renouxfabrice/action-camera-orthophoto-validation/hardware/rolling_shutter_bench/README.md

# The LED bench

Bill of materials, wiring and the blink rates used.
