renouxfabrice/action-camera-orthophoto-validation/src/photogrammetry/README.md

# Processing

ODM project preparation, camera model import, orthophoto quality control.
