renouxfabrice/action-camera-orthophoto-validation/data/derived/rolling_shutter/README.md

# Measured readout times

One row per camera and capture mode, with uncertainty and number of repeats.
