renouxfabrice/action-camera-orthophoto-validation/data/raw/drone_flight/README.md

# Instrumented flight

Images, mission logs, GNSS rover and base logs, ground control, weather, flight plan.
