renouxfabrice/action-camera-orthophoto-validation/data/raw/rolling_shutter/README.md

# Raw bench photographs

One folder per camera model and capture mode, with the manifest recording blink rate, exposure, ISO and distance.
