renouxfabrice/action-camera-orthophoto-validation/data/echantillon/hero4_champ_large_7mpx/GOPR3876.JPG

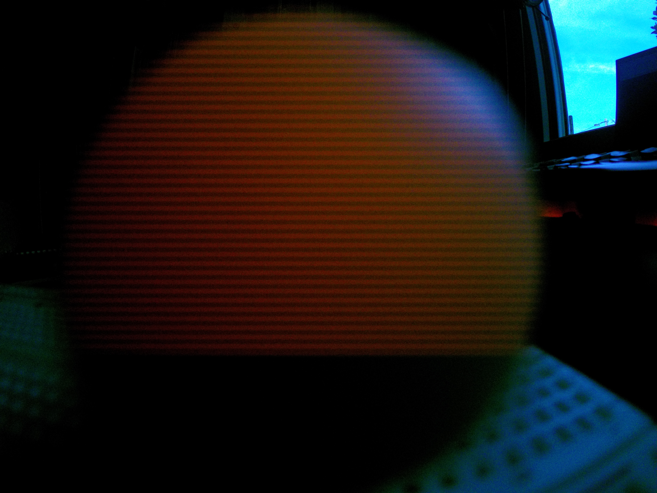
data/echantillon/hero4_champ_large_7mpx/GOPR3876.JPG
