renouxfabrice/action-camera-orthophoto-validation/data/echantillon/hero4_champ_large_12mpx/GOPR2091.JPG

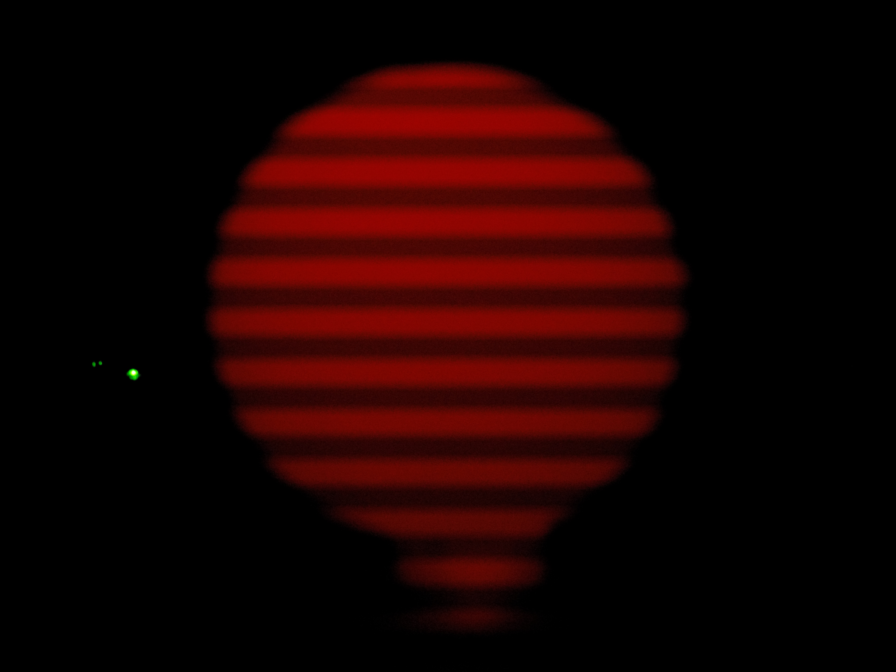
data/echantillon/hero4_champ_large_12mpx/GOPR2091.JPG
