renouxfabrice/action-camera-orthophoto-validation/data/echantillon/hero4_champ_moyen_7mpx/GOPR2212.JPG

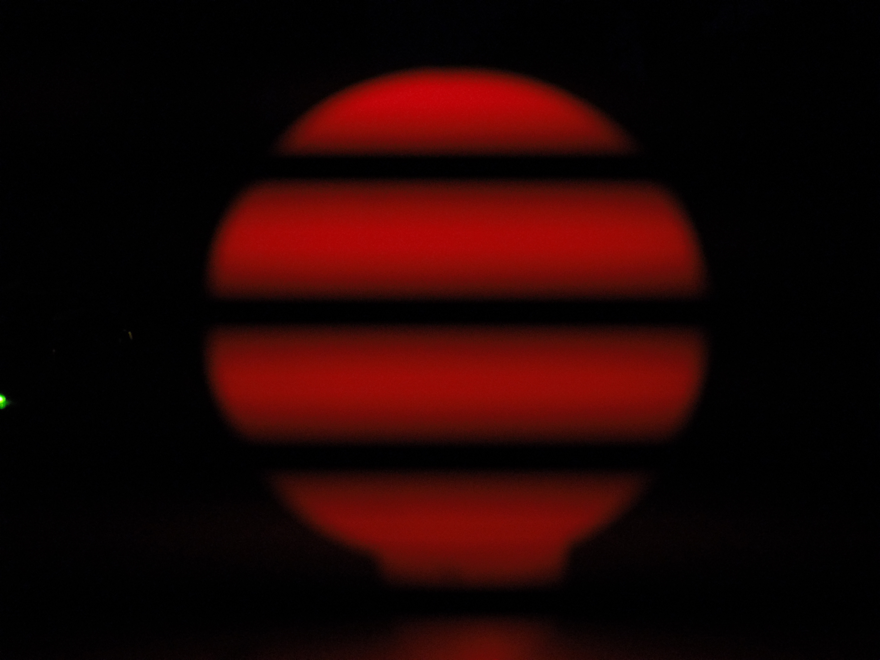
data/echantillon/hero4_champ_moyen_7mpx/GOPR2212.JPG
