renouxfabrice/action-camera-orthophoto-validation/data/echantillon/hero4_champ_moyen_7mpx/GOPR2308.JPG

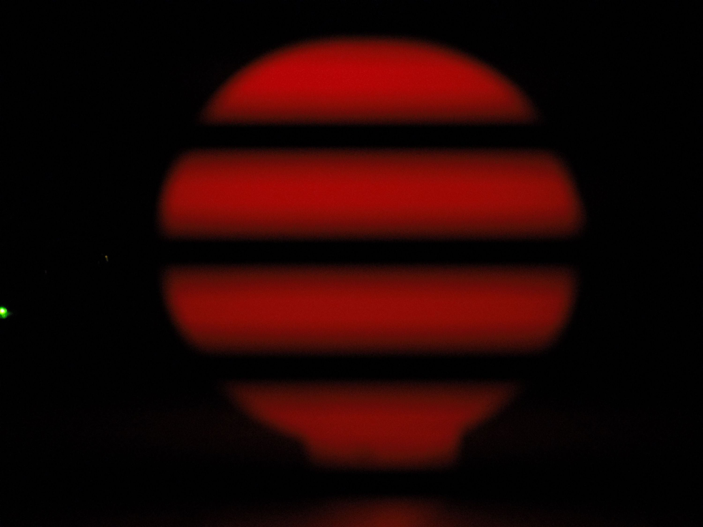
data/echantillon/hero4_champ_moyen_7mpx/GOPR2308.JPG
