renouxfabrice/action-camera-orthophoto-validation/data/echantillon/hero13_lineaire_iso800/GP010539.JPG

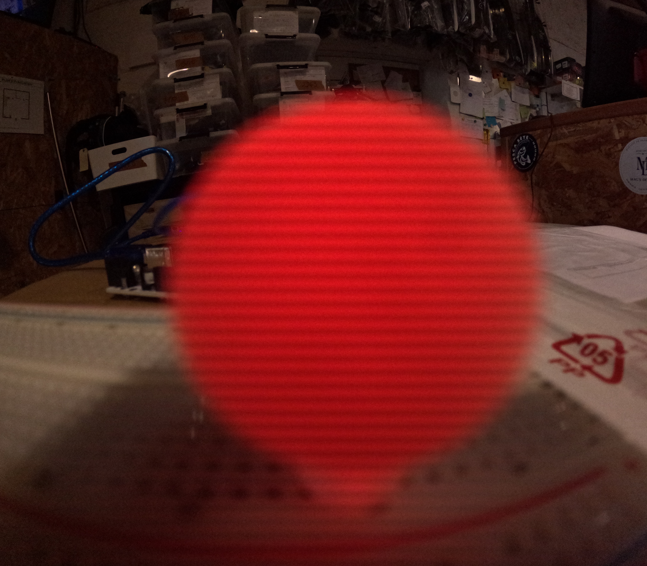
data/echantillon/hero13_lineaire_iso800/GP010539.JPG
