renouxfabrice/action-camera-orthophoto-validation/data/echantillon/hero13_lineaire_iso800/GP010551.JPG

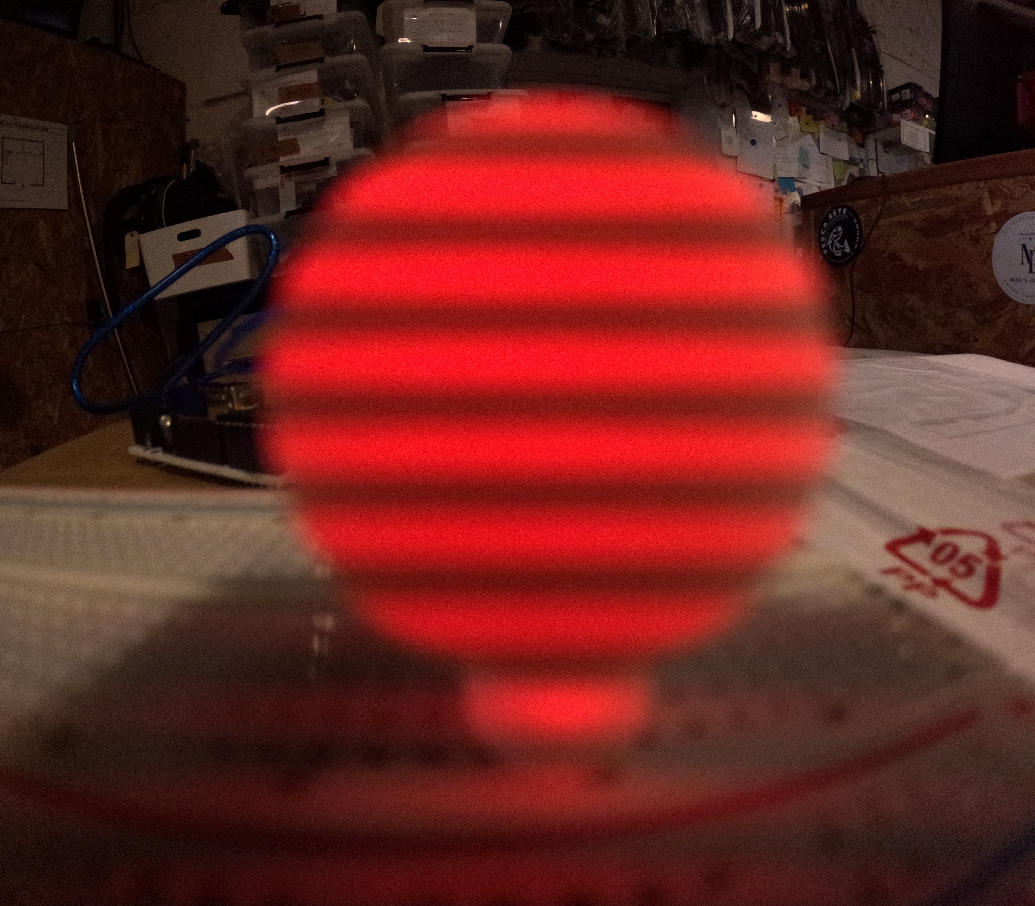
data/echantillon/hero13_lineaire_iso800/GP010551.JPG
