renouxfabrice/action-camera-orthophoto-validation/data/echantillon/hero13_lineaire_iso_auto/GP010460.JPG

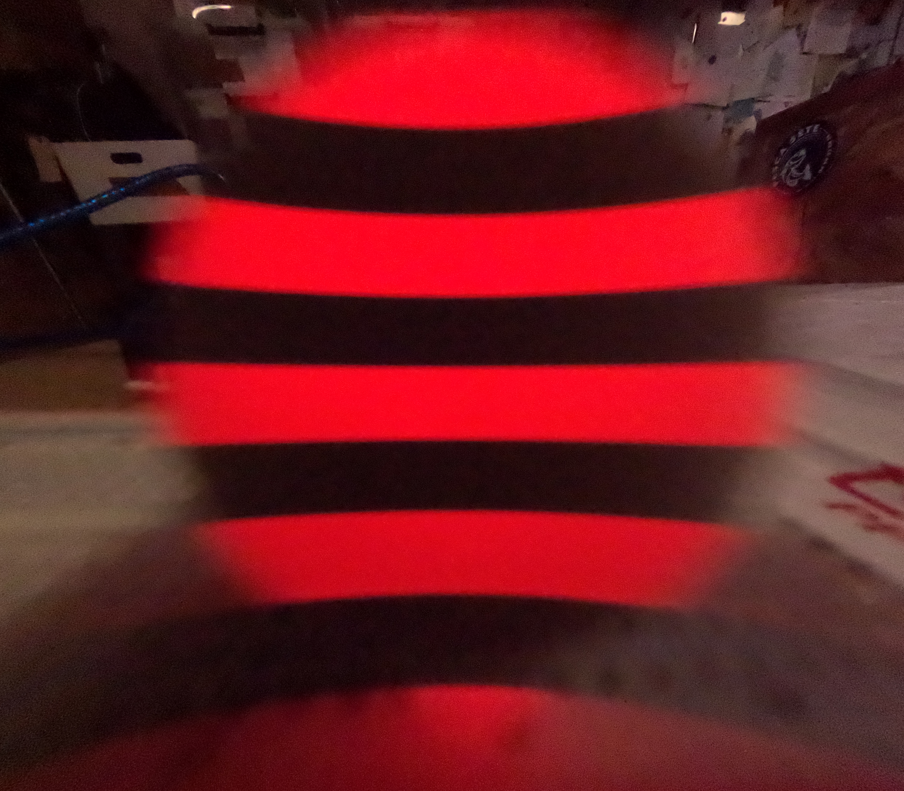
data/echantillon/hero13_lineaire_iso_auto/GP010460.JPG
