renouxfabrice/action-camera-orthophoto-validation/data/echantillon/hero13_wide/GP010384.JPG

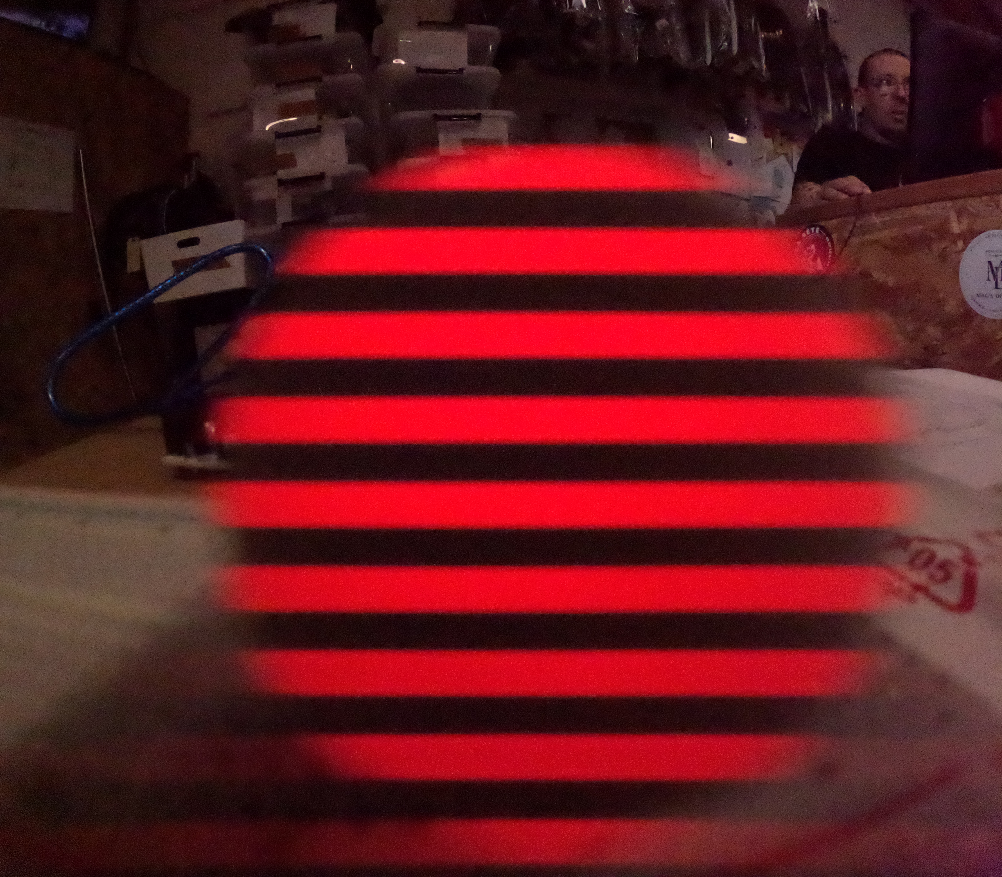
data/echantillon/hero13_wide/GP010384.JPG
