renouxfabrice/action-camera-orthophoto-validation/data/echantillon/hero13_wide/GP010391.JPG

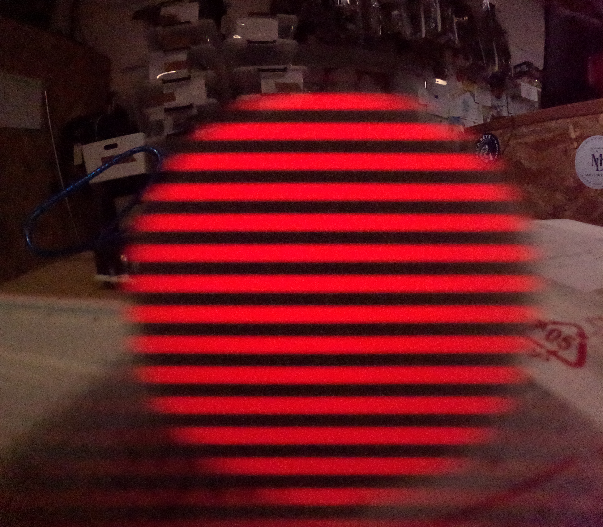
data/echantillon/hero13_wide/GP010391.JPG
