renouxfabrice/action-camera-orthophoto-validation/data/echantillon/hero13_wide/GP010405.JPG

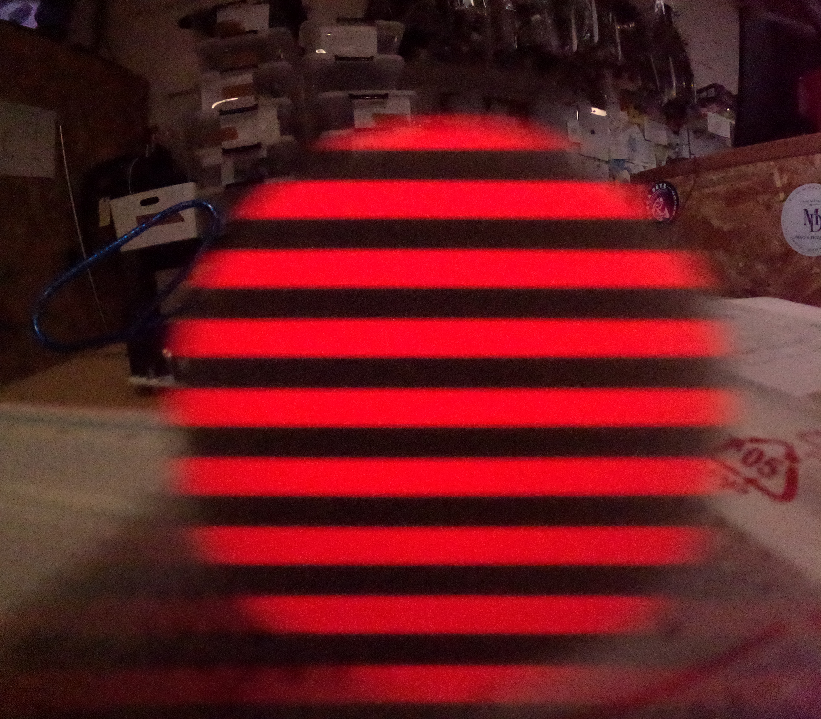
data/echantillon/hero13_wide/GP010405.JPG
