renouxfabrice/action-camera-orthophoto-validation/data/raw/calibration/README.md

# Calibration images

Target photographs per camera and mode.
