renouxfabrice/action-camera-orthophoto-validation/data/derived/orthophoto_validation/README.md

# Orthophoto control

Checkpoint residuals. GCP and checkpoint roles must never be mixed in a published RMSE.
